Kadam-Yash-Sachin/Balance-Bot/Hardware/MEDBOT.png

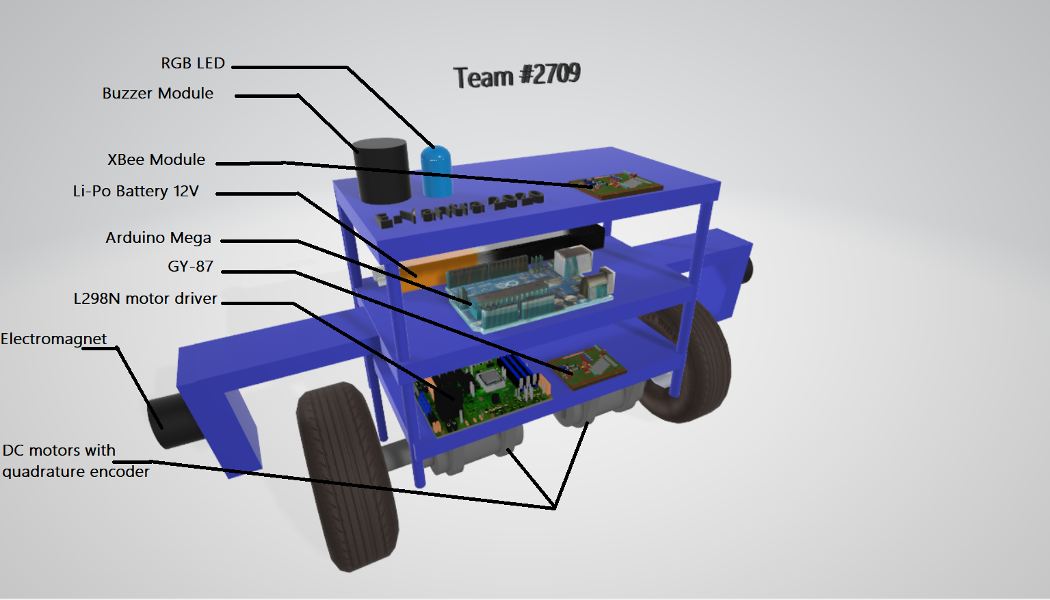
Hardware/MEDBOT.png
