Kadam-Yash-Sachin/Balance-Bot/Hardware/YARK1.jpeg

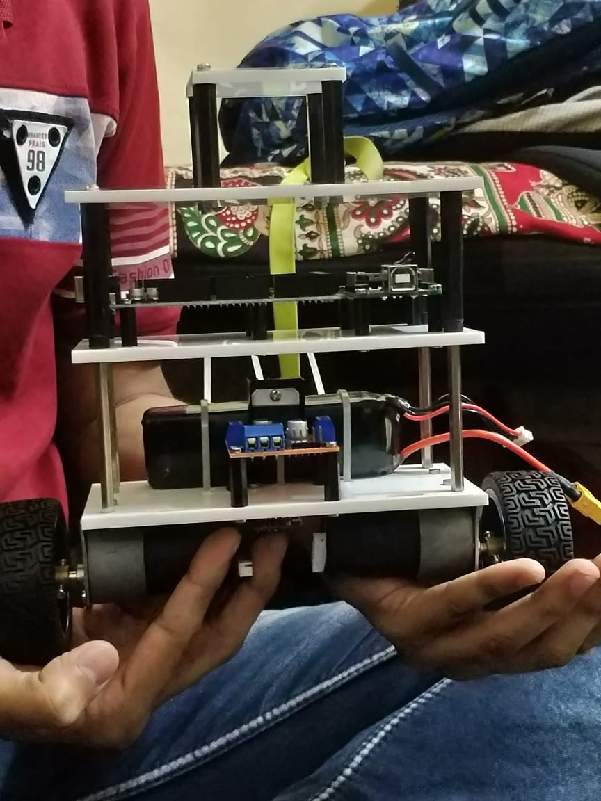
Hardware/YARK1.jpeg
