Kadam-Yash-Sachin/Balance-Bot/README.md

# Balance-Bot
A self Balancing Bot and its arena designed for the e-yantra robotics competition 2020
