Kadam-Yash-Sachin/Balance-Bot/Hardware/Arena_team_LI.jpg

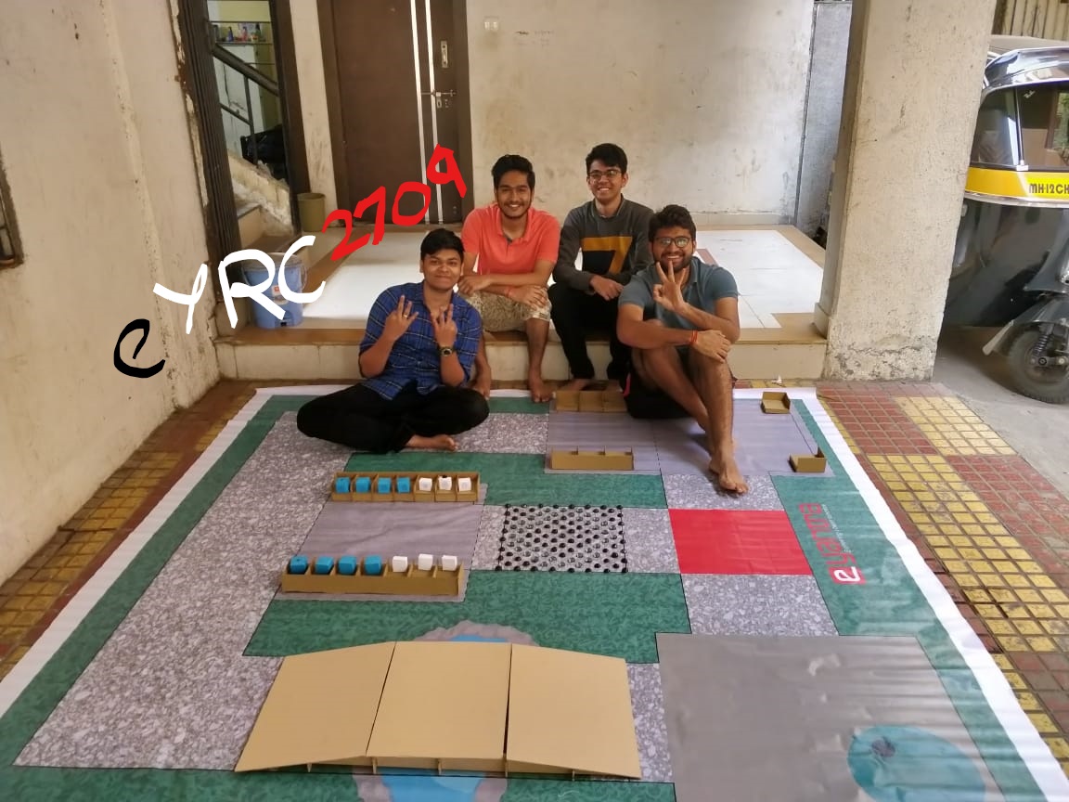
Hardware/Arena_team_LI.jpg
