Kadam-Yash-Sachin/Balance-Bot/Hardware/remote1.jpeg

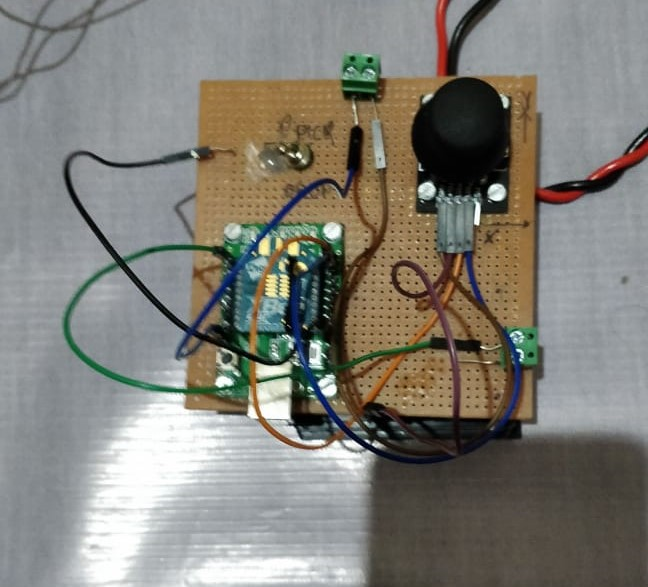
Hardware/remote1.jpeg
