Kadam-Yash-Sachin/Balance-Bot/Hardware/Remote2.jpeg

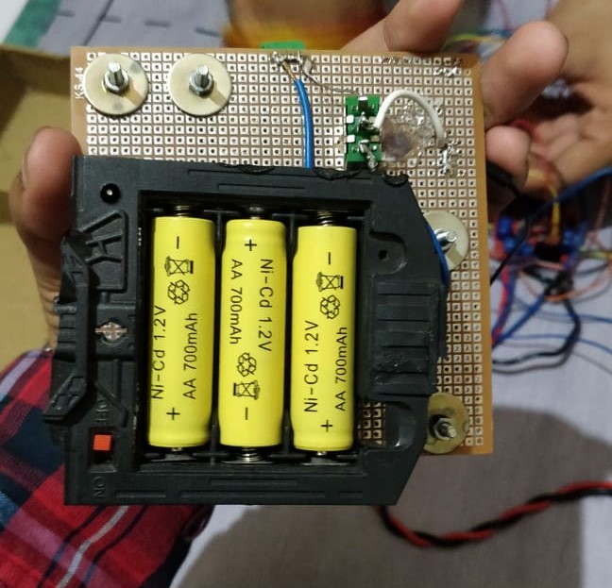
Hardware/Remote2.jpeg
