Kadam-Yash-Sachin/Balance-Bot/Hardware/Remote3.jpeg

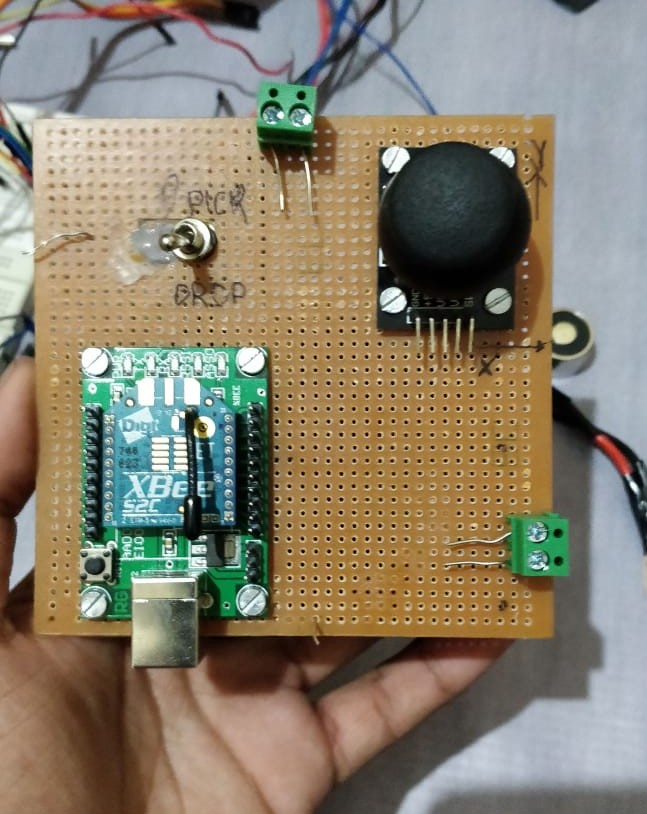
Hardware/Remote3.jpeg
